HydroPWNics/ADSensorModule-Hardware/README.md

# ADSensorModule-Hardware
Combination Analog and Digital sensor module, entirely wireless
