HydroPWNics/ADSensorModule-Hardware/(list of files, drawings)

Other design files:
PCB/AD Sensor Module.PcbDoc
PCB/AD Sensor Module.PrjPcb
PCB/AD Sensor Module.SchDoc
PCB/Other/AD Sensor Module - SC.PcbDoc
PCB/Other/AD Sensor Module - SC.SchDoc
