HydroPWNics/ADSensorModule-Hardware/(commit log)

2016-02-23 Initial Commit
    Initial Commit of the AD Module. THe AD Module is a combination hardware
    module that combines the functionality of the analog sensor module the
    digitial sensor module and the module hub into a single piece of
    hardware that will stream sensor data and other info to a wireless
    gateway to the Vivaplanet cloud.
    [AD Sensor Module.PcbDoc, AD Sensor Module.PrjPcb, AD Sensor Module.SchDoc]
2016-02-26 Huge Changes
    Power supply completely redesigned around the following topology: USB
    bus power for development and point of application power, solar charged
    super capacitor power for remote operation, DCDC buck boost converter
    for supplying 3V3 in either power source use cases. Auto power siwtching
    between two sources for buck/boost regulator. Super cap charging
    accomplished with dedicated IC, auto switching occurs form a VBUS
    triggered mosfet/diode circuit.
    [AD Sensor Module.PcbDoc, AD Sensor Module.PrjPcb, AD Sensor Module.SchDoc]
2016-02-27 Connectors
    Connectors swapped for grove style connectors (through hole). SMT
    versions were too large to shave significant space off PCB size.
    [AD Sensor Module.PcbDoc, AD Sensor Module.PrjPcb, AD Sensor Module.SchDoc]
2016-02-28 Power System
    Subsections of power supply system have bee laid out and routed. The
    buck boost regulator and the MPPT solar super cap charging circuit.
    [AD Sensor Module.PcbDoc, AD Sensor Module.SchDoc]
2016-03-10 Big Changes
    Switching the design in several ways: Move to LiPo battery power system
    with USB charging and FTDI programming. Now supporting only digital
    Seeedstudio Grove sensors via UART and I2C. Microcontroller switched to
    a MKL1x series from FreeScale.
    [AD Sensor Module - SC.PcbDoc, AD Sensor Module - SC.SchDoc, AD Sensor Module.PcbDoc, AD Sensor Module.SchDoc]
2016-03-10 New MCU
    Made the footprint for the new MCU and added it to the schematic.
    [AD Sensor Module.PrjPcb, AD Sensor Module.SchDoc]
2016-03-11 New Schematic Complete
    New shematic design completed, but subject to change during board
    routing process. Also in this update footprints added for the crystal,
    loading caps, battery connector, and more resistors for the battery
    charge control IC.
    [AD Sensor Module.PcbDoc, AD Sensor Module.PrjPcb, AD Sensor Module.SchDoc]
2016-03-25 switching workstations
    [AD Sensor Module.PcbDoc, AD Sensor Module.PrjPcb, AD Sensor Module.SchDoc]
